Mubeg/Music-Box/README.md

# [Music Box](modules/ROOT/pages/index.adoc)
Данилов Никита Сергеевич  
Черникова Анастасия Алексеевна  

МФТИ ФРКТ, 2023
