Mubeg/Music-Box/modules/ROOT/pages/corpus_phys.adoc

ifdef::env-github[]
:imagesdir: ../images/
endif::[]
ifdef::env-vscode[]
:imagesdir: ../images/
endif::[]
== Производство корпуса

Имея готовый проект осталось только запустить лазерную резку изделия из фанеры.




Можно приступить к xref:corpus_build.adoc[cборке корпуса].
