Mubeg/Music-Box/modules/ROOT/nav.adoc

ifdef::env-github[]
:relfileprefix: pages/
endif::[]
* xref:index.adoc[Музыкальная шкатулка]
** xref:natural_modeling.adoc[1 - Натуральное моделирование]
** xref:shema.adoc[2 - Разработка схемы]
** xref:plata_teor.adoc[3 - Разработка печатной платы]
** xref:plata_phys.adoc[4 - Производство печатной платы]
** xref:corpus_teor.adoc[5 - Разработка корпуса]
** xref:corpus_phys.adoc[6 - Производство корпуса]
** xref:corpus_build.adoc[7 - Сборка копуса]
** xref:plana_build.adoc[8 - Пайка платы]
** xref:complete.adoc[9 - Сборка изделия]
* xref:result.adoc[Результат]
