Mubeg/Music-Box/modules/ROOT/pages/corpus_teor.adoc

ifdef::env-github[]
:imagesdir: ../images/
endif::[]
ifdef::env-vscode[]
:imagesdir: ../images/
endif::[]
== Разработка корпуса

В процессе обсуждения корпуса нашей шкатулки было рассмотрено много различных идей. Но мы решили, что самым эффектным вариантом будет сделать рояль с некоторыми подвижными деталями. В этом случае может быть одновременно хорошо виден корпус, электронная схема и останется место для хранения (изначальная цель любой шкатулки). Для реализации была использована программа CorelDraw, в которой был спроектирован корпус.
Имея результаты прошлых этапов, мы задали необходимый размер, чтобы свободно разместить печатную плату на передней панели.

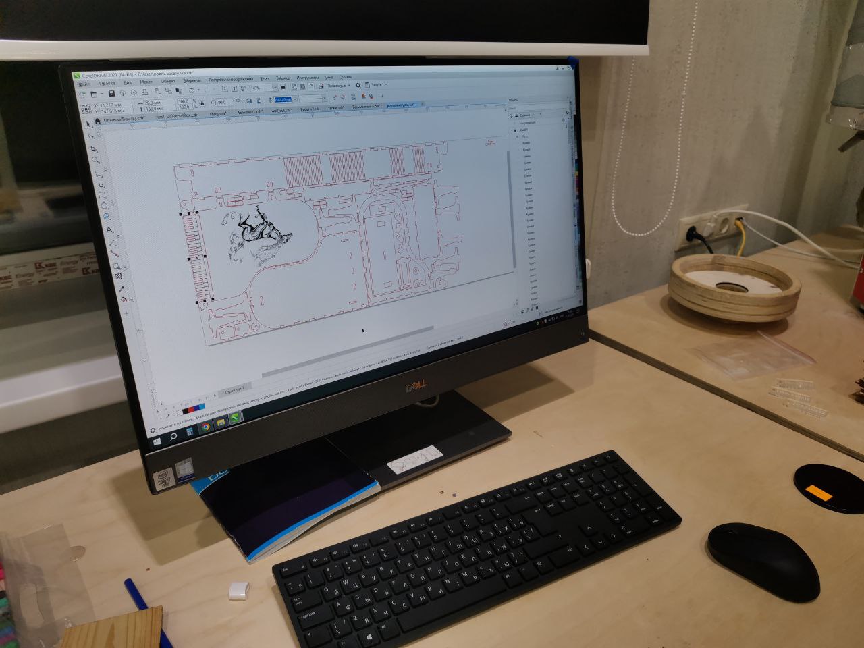
[picture p1: modules/ROOT/images/corpus_2.jpg]


Поскольку в качестве материала для корпуса выступает фанера, для создания изгибов мы прорезали дерево тонкими линиями в специальной последовательности.

Можно приступить к xref:corpus_phys.adoc[производству корпуса].
