Mubeg/Music-Box/modules/ROOT/pages/index.adoc

ifdef::env-github[]
:imagesdir: ../images/
endif::[]
ifdef::env-vscode[]
:imagesdir: ../images/
endif::[]
== Музыкальная шкатулка

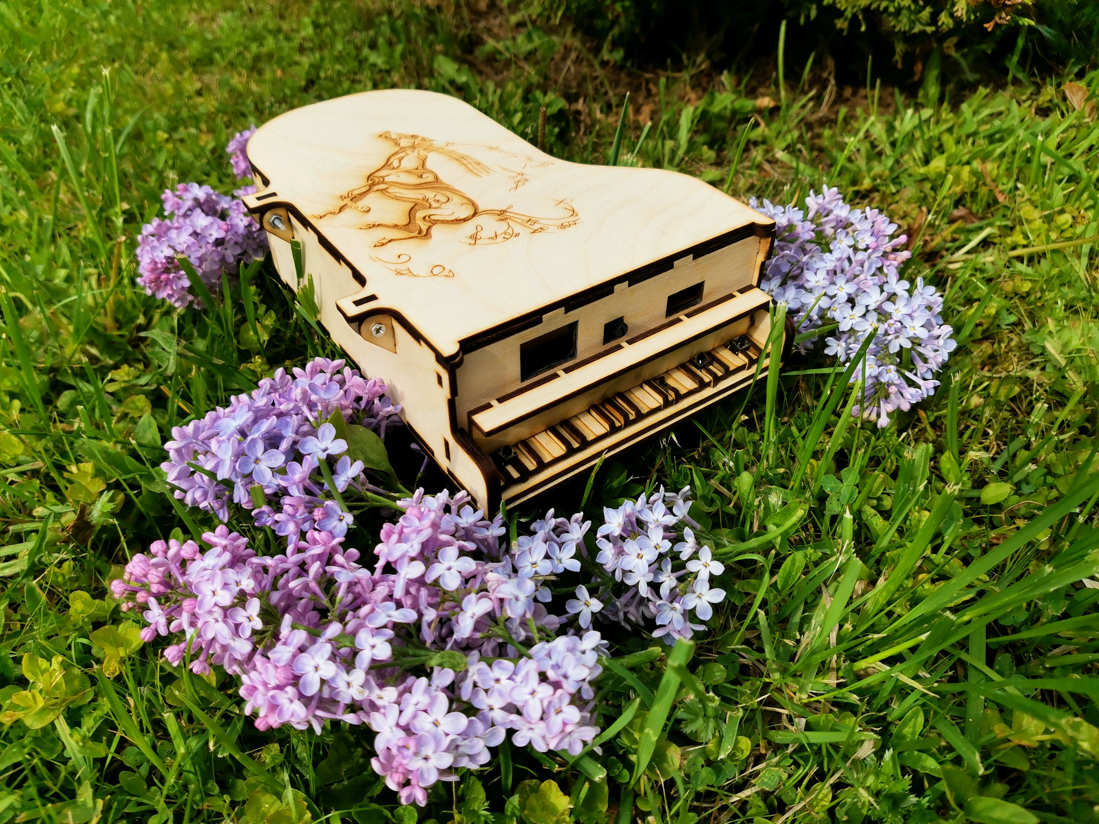
[picture p2: modules/ROOT/images/box_front.jpg]


Все хорошо знакомы со старинными музыкальными шкатулками. Это красивое механическое изделие, которое, к сожалению, способно проигрывать только одну мелодию. Мы захотели создать свою шкатулку, которая сможет воспроизводить любое количество любимых песен и будет радовать своей красотой. С поставленной задачей изделие успешно справляется.

.Пройденные этапы:
. xref:natural_modeling.adoc[Натуральное моделирование]
. xref:shema.adoc[Разработка схемы]
. xref:plata_teor.adoc[Разработка печатной платы]
. xref:plata_phys.adoc[Производство печатной платы]
. xref:corpus_teor.adoc[Разработка корпуса]
. xref:corpus_phys.adoc[Производство корпуса]
. xref:corpus_build.adoc[Сборка корпуса]
. xref:plana_build.adoc[Пайка платы]
. xref:complete.adoc[Сборка изделия]

== xref:result.adoc[Результат]
