Mubeg/Music-Box/modules/ROOT/pages/complete.adoc

ifdef::env-github[]
:imagesdir: ../images/
endif::[]
ifdef::env-vscode[]
:imagesdir: ../images/
endif::[]
== Сборка изделия

Склейка уже готовых элементов произошла без проблем.

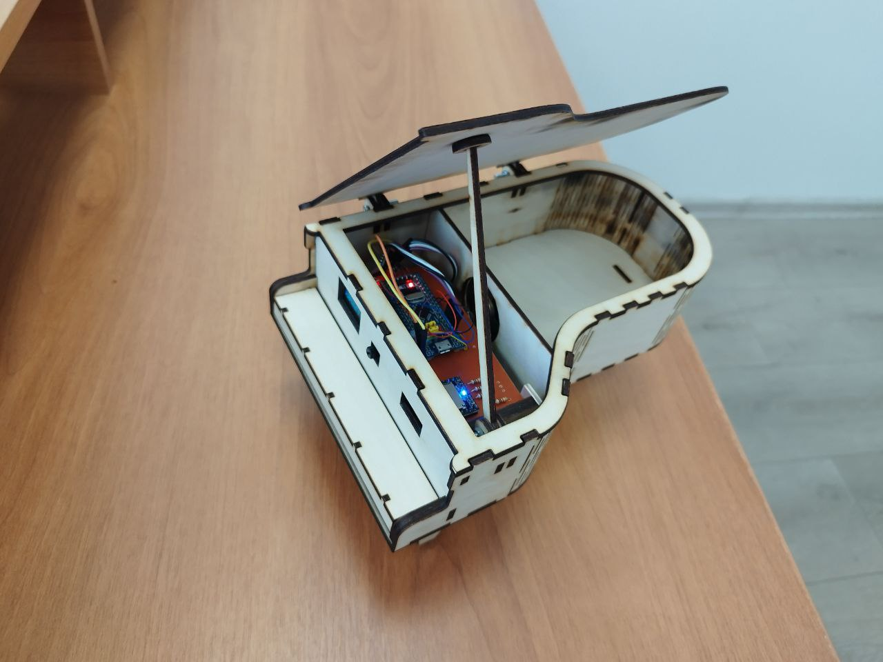
[picture p3: modules/ROOT/images/box_open.jpg]


Дальше необходимо было припаять держатель для батареек. После этого осталось только приклеить последние детали и поставить плату на её место.

После включения питания изделие отказывалось читать SD-карту и играть музыку. Для выяснения причины пришлось проверить напряжения и сопротивления на всей схеме. Узнать её удалось довольно быстро: железный конец резистора отпаялся от окружавшего его олова и потерял контакт. Проблема была быстро решена.

Теперь осталось лишь любоваться xref:result.adoc[результатом].
