Mubeg/Music-Box/modules/ROOT/pages/plata_phys.adoc

ifdef::env-github[]
:imagesdir: ../images/
endif::[]
ifdef::env-vscode[]
:imagesdir: ../images/
endif::[]
== Производство печатной платы

Для производства печатной платы, необходимо станку Charly4U описать задачу. Для этого использовалась программа FlatCAM. После выбора нужных инструментов и количества проходов для добавления окантовки дорожкам, получилась следующая схема.

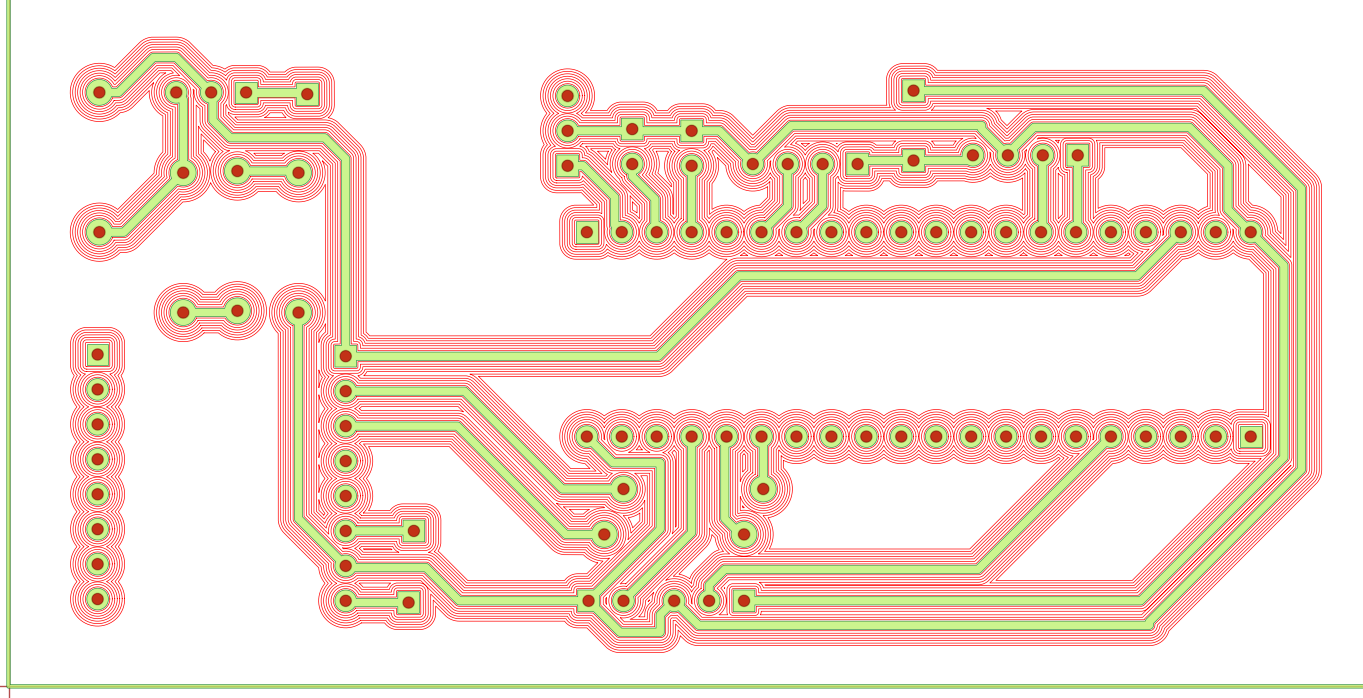
[picture p4: modules/ROOT/images/FlatCam.png]


Этот файл транслируется в формат, который читается станком и, после необходимой настройки, запускается производство.

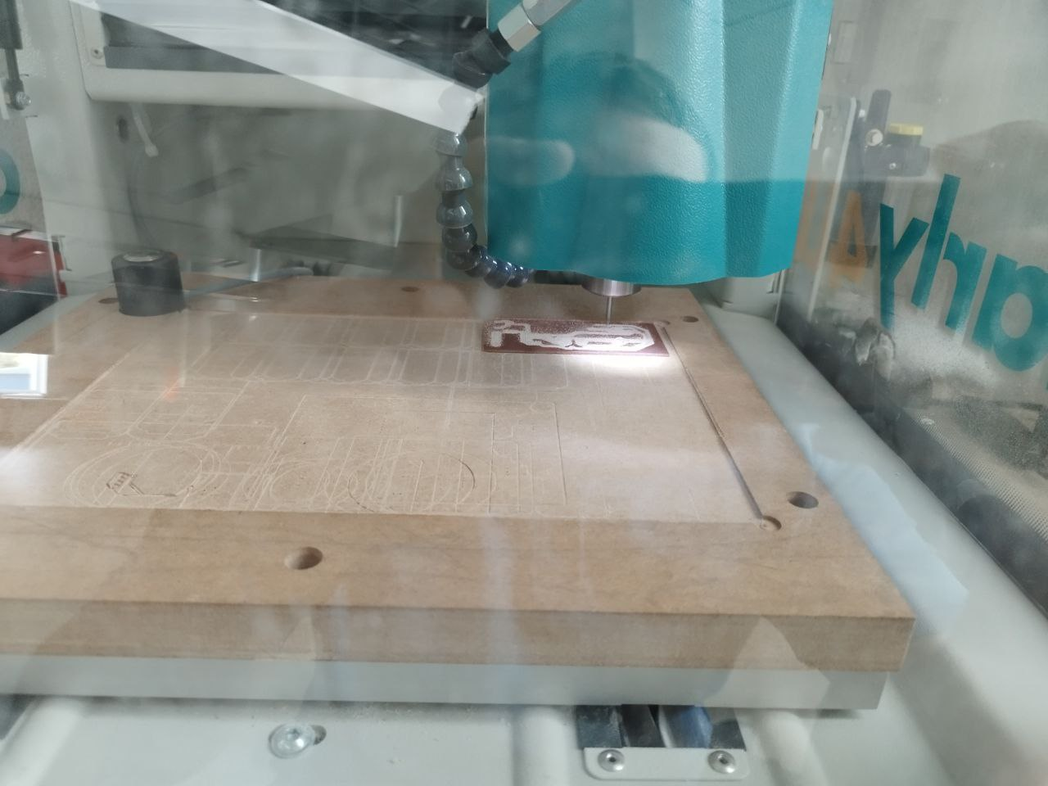
[picture p5: modules/ROOT/images/plata_process.jpg]


Процесс фрезеровки занял 22 минуты, а сверления - 2 минуты. Таким образом суммарное время на изготовку одной платы составляет ~30 минут.

В результате получается медная пластина с вырезанными дорожками и просверленными отверстиями.

Пока готовится плата параллельно можно заниматься xref:corpus_teor.adoc[разработкой корпуса] для изделия.
