Mubeg/Music-Box/modules/ROOT/pages/plata_teor.adoc

ifdef::env-github[]
:imagesdir: ../images/
endif::[]
ifdef::env-vscode[]
:imagesdir: ../images/
endif::[]
== Разработка печатной платы

После создания схемы, её необходимо преобразовать в печатную плату. Мы расположили все элементы на плате и соединили их дорожками - развели плату.

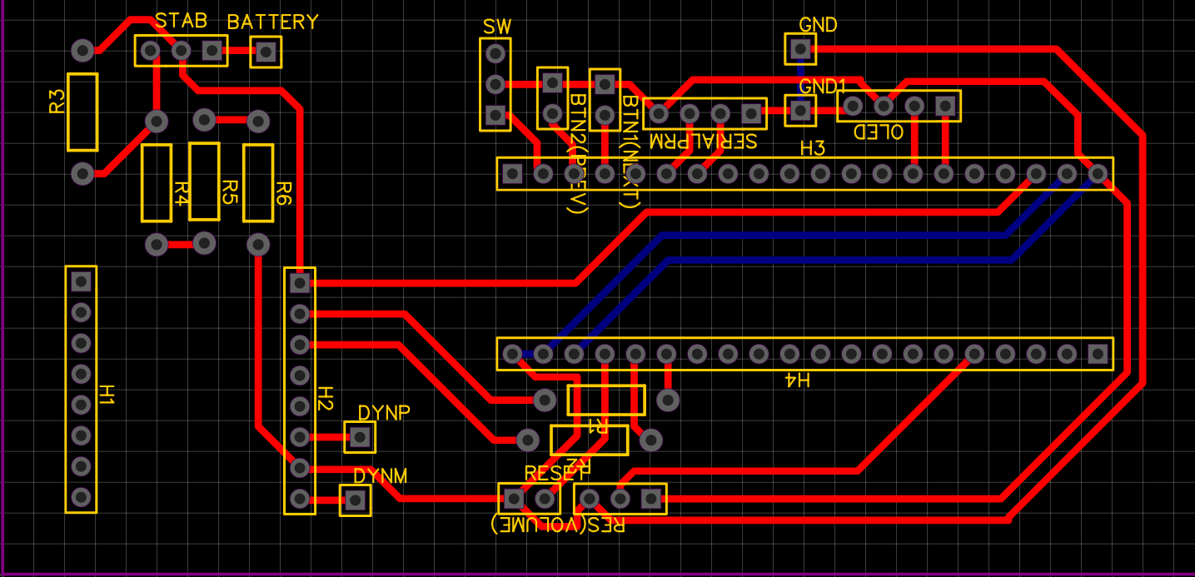
[picture p6: modules/ROOT/images/PCB.png]


Нам были доступны только односторонние медные платы. Это ограничило способы соединения элементов. Из-за этого нам пришлось использовать перемычку, добавленную на этапе пайки. Но место под неё было отведено на текущем этапе.

Процесс работы над печатной платой шёл не так гладко:

* Нам пришлось использовать дорожки на задней плоскости платы, которой не существует (дорожки на изображении отмечены синим), чтобы программа смогла правильно подсказать необходимую разводку. Причина заключается в том, что на плате stm32 3 контакта должны соединяться с землёй, и два с питанием 3,3 В.
* На этом этапе неожиданным образом проявила себя ошибка из предыдущего этапа. Тогда были перепутаны местами земля с питанием. Но, после исправления этой ошибки, логический помощник, продолжал думать, что питание нужно соединить с землей, хотя не давал подключить ни питание к питанию, ни питание к земле. В итоге пришлось вручную изменить номер дорожки питания. На этом этапе мы до конца не понимали, была ли здесь допущена ошибка в соединении каких-либо контактов.
* Последняя сложность заключалась в том, что в процессе разведения платы, о положении компонентов нужно думать зеркально.

После решения всех этих проблем, осталось расположить все компоненты на плату и соединить их. Результат показан на схеме.

В итоге мы упустили только то, что mp3 плеер с разъёмом под sd карту должен был находиться на самом краю платы. Это необходимо, чтобы пользователю было удобно доставать карту для перезаписи музыки.

Настало время приступить к xref:plata_phys.adoc[производству печатной платы].
