Mubeg/Music-Box/modules/ROOT/pages/shema.adoc

ifdef::env-github[]
:imagesdir: ../images/
endif::[]
ifdef::env-vscode[]
:imagesdir: ../images/
endif::[]
== Разработка схемы

Для разработки печатной платы необходимо создать схему электрической цепи нашего изделия. Для этой цели была выбрана программа https://easyeda.com/[EasyEDA], где создали схему.

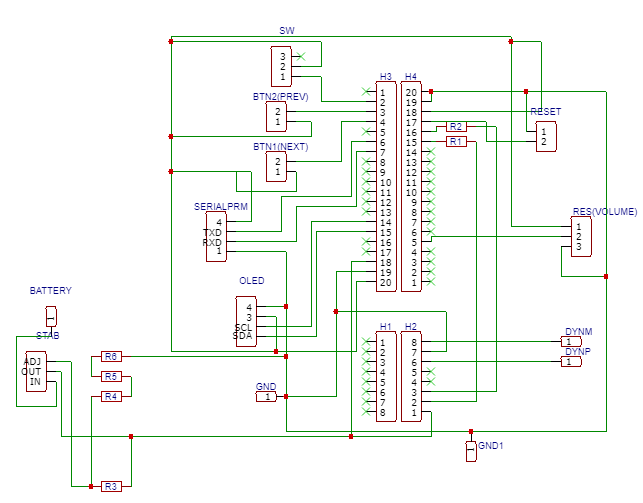
[picture p7: modules/ROOT/images/Shema.png]


Здесь представлены все компоненты с этапа натурального моделирования, но присутствуют некоторые дополнения: добавлен стабилизатор питания, а также кнопка принудительного перезапуска программы микроконтроллера.

В каталоге EasyEDA не было найдено разметки для платы stm32, поэтому нам пришлось её моделировать самостоятельно. В итоге микроконроллер выглядит как два набора по 20 пинов, а mp3-плеер - по 8. Аналогично представлены и другие компоненты.

На рисунке представлена последняя версия схемы, однако, изначально в ней была допущена одна ошибка (mp3 плеер был присоединен питанием к земле). Проблема была быстро исправлена, однако она проявила себя неожиданным образом на этапе xref:plata_teor.adoc[разработки печатной платы].
