Mubeg/Music-Box/modules/ROOT/pages/natural_modeling.adoc

ifdef::env-github[]
:imagesdir: ../images/
endif::[]
ifdef::env-vscode[]
:imagesdir: ../images/
endif::[]
== Натуральное моделирование

Первым этапом в разработке проекта стало натуральное моделирование. На макетной плате была собрана электронная составляющая шкатулки. Были отработаны протоколы взаимодействия микроконтроллера с экраном, mp3-плеером, кнопками, переключателями, потенциометром и динамиком.

.Использованные компоненты:

*   Stm32F103C8T6
*   OLED-экран
*   Mp3-плеер с функцией чтения SD-карты
*   3 кнопки
*   2 переключателя
*   Динамик 0.5 Вт
*   Потенциометр
*   Стабилизатор питания  

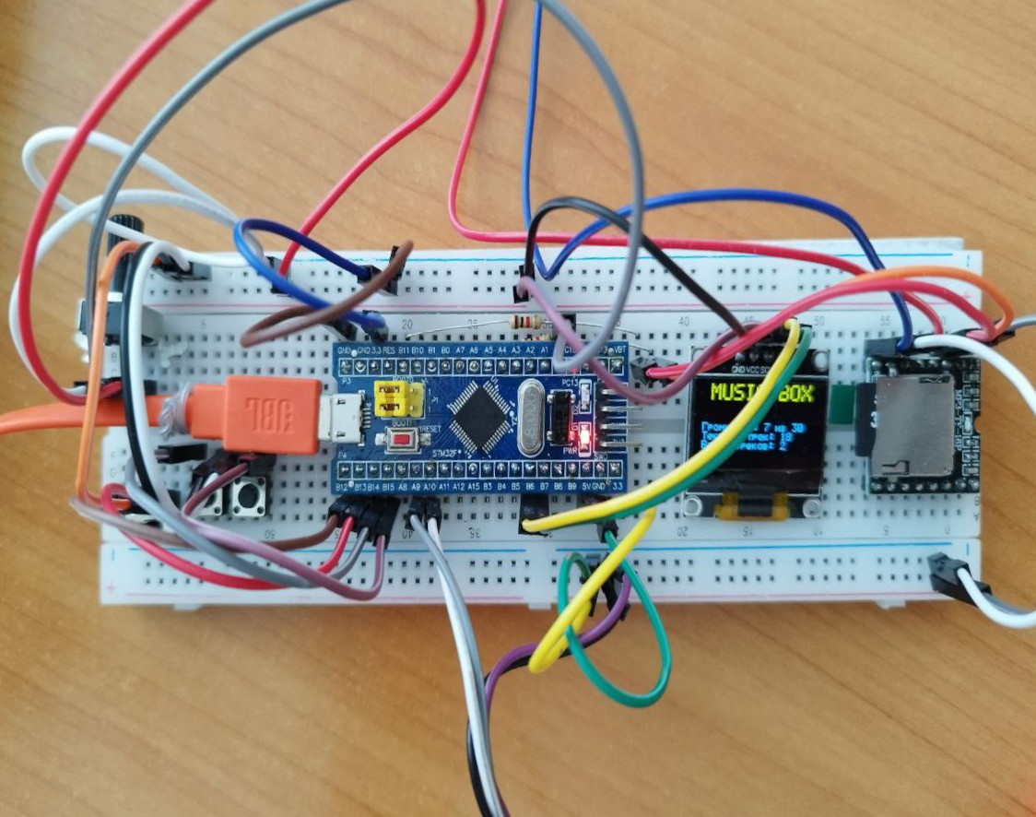
[picture p8: modules/ROOT/images/natural_modeling.jpg]


На этом этапе мы отладили первый вариант кода программы. Но в представленной схеме мы не смогли всё продумать до конца. В дальнейшем будут добавлены питание от батареек (на этой схеме питание подаётся через usb-провод из повербанка), кнопки выключения и перезагрузки.

Некоторые проблемы, оставшиеся от этапа натурального моделирования удалось решить на этапе xref:shema.adoc[разработки схемы].
