Mubeg/Music-Box/(list of files, drawings)

Other design files:
modules/ROOT/sources/EasyEda/1-PCB_PCB_New Project.json
modules/ROOT/sources/EasyEda/1-Schematic_New Project.json
