Mubeg/Music-Box/modules/ROOT/sources/Gerber_PCB_PCB_Electronics_2_1_2023-05-12/How-to-order-PCB.txt

How to Order PCB

Please refer to:
https://docs.easyeda.com/en/PCB/Order-PCB
