Mubeg/Music-Box/modules/ROOT/pages/corpus_build.adoc

ifdef::env-github[]
:imagesdir: ../images/
endif::[]
ifdef::env-vscode[]
:imagesdir: ../images/
endif::[]
== Сборка корпуса

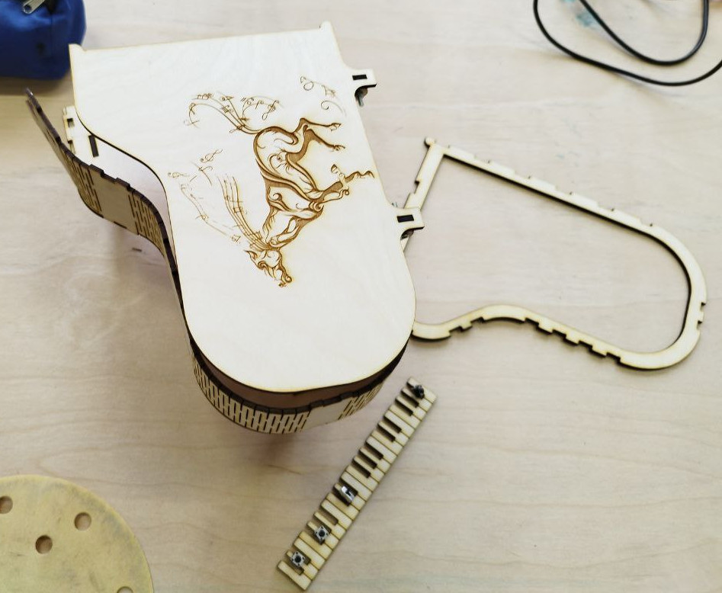
[picture p9: modules/ROOT/images/box_assembly.jpg]


На этапе сборки корпуса было придумано решение разместить кнопки управления как клавиши рояля, что потребовало некоторых изменений в конструкции. Так, панель с белыми клавишами и передней стенкой была размещена выше запланированного места, чтобы можно было проложить провода до кнопок.

Также на этом этапе была произведена новая передняя панель с вырезанными отверстиями под SD-карту, потенциометр и экран.

Помимо прочего, была изготовлена конструкция удержания печатной платы на необходимой высоте, под неё мы поместили корпус с батарейками.

Вся конструкция будет склеиваться воедино уже на следующем этапе, когда будет xref:plana_build.adoc[спаяна печатная плата].
