Mubeg/Music-Box/modules/ROOT/pages/plana_build.adoc

ifdef::env-github[]
:imagesdir: ../images/
endif::[]
ifdef::env-vscode[]
:imagesdir: ../images/
endif::[]
==  Пайка платы

Для завершения этапа разработки электроники, осталось припаять все компоненты на плату и проверить её работоспособность.

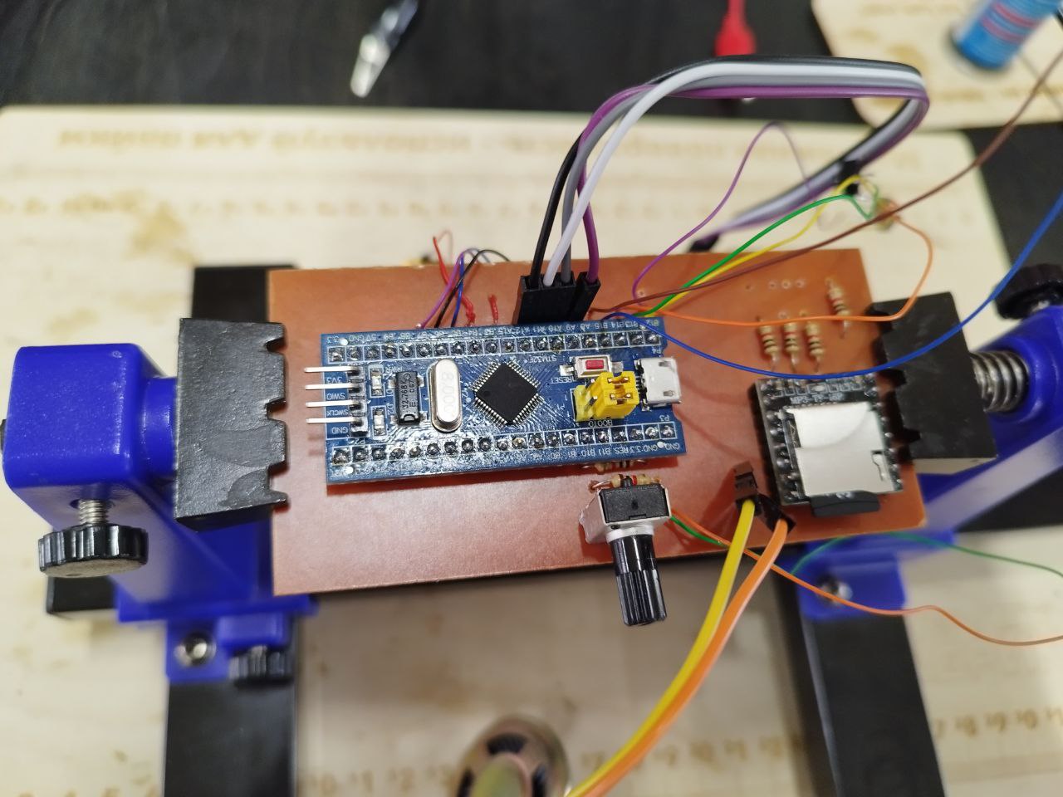
[picture p10: modules/ROOT/images/plata_front.jpg]

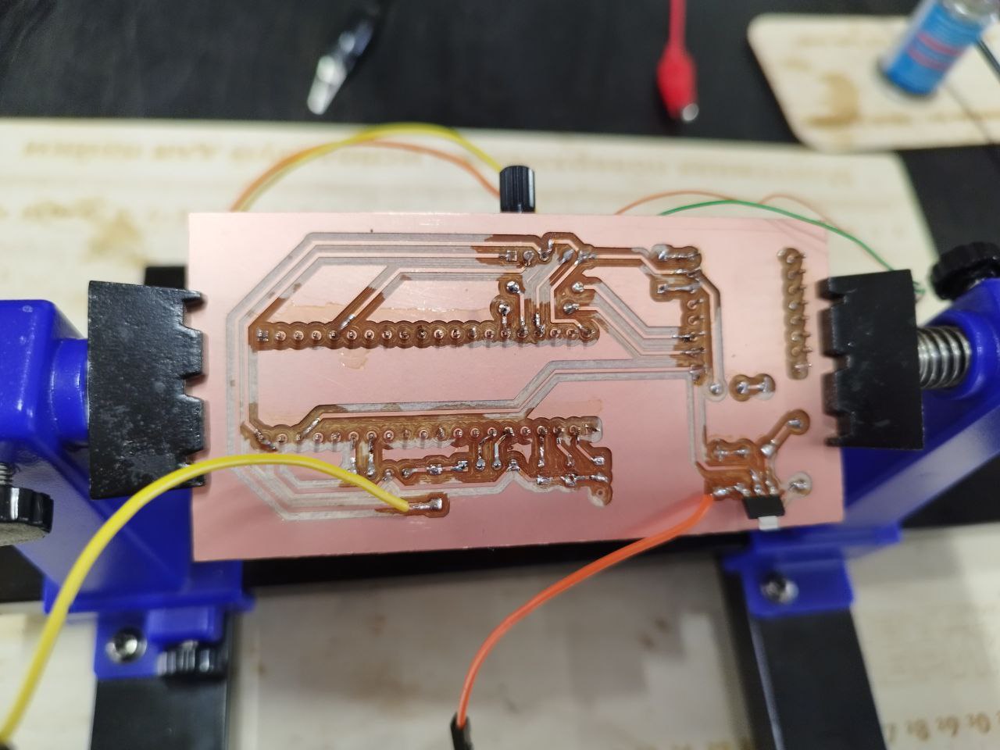
[picture p11: modules/ROOT/images/palata_back.jpg]


.Процесс пайки прошел гладко, за исключением фактора:

* В месте крепления питания стабилизатора, отклеился медный слой, что исключило использование данного контакта. Для обхода возникшей проблемы, провод питания был присоединен напрямую к стабилизатору.

В итоге - подключаем плату к источнику питания - и она работает! :D

На одну неизвестность меньше, приступаем к xref:complete.adoc[сборке изделия].
