Mubeg/Music-Box/modules/ROOT/pages/result.adoc

ifdef::env-github[]
:imagesdir: ../images/
endif::[]
ifdef::env-vscode[]
:imagesdir: ../images/
endif::[]
== Результат

Получилось красивое и функциональное изделие.

.Преимущества:
* Качественное и громкое звучание
* До 300 часов работы в режиме ожидания
* До 30 часов работы в режиме умеренной громкости
* Безграничное количество треков *
* Объемное место для хранения предметов

(*) До 32 ГБ на SD-карте



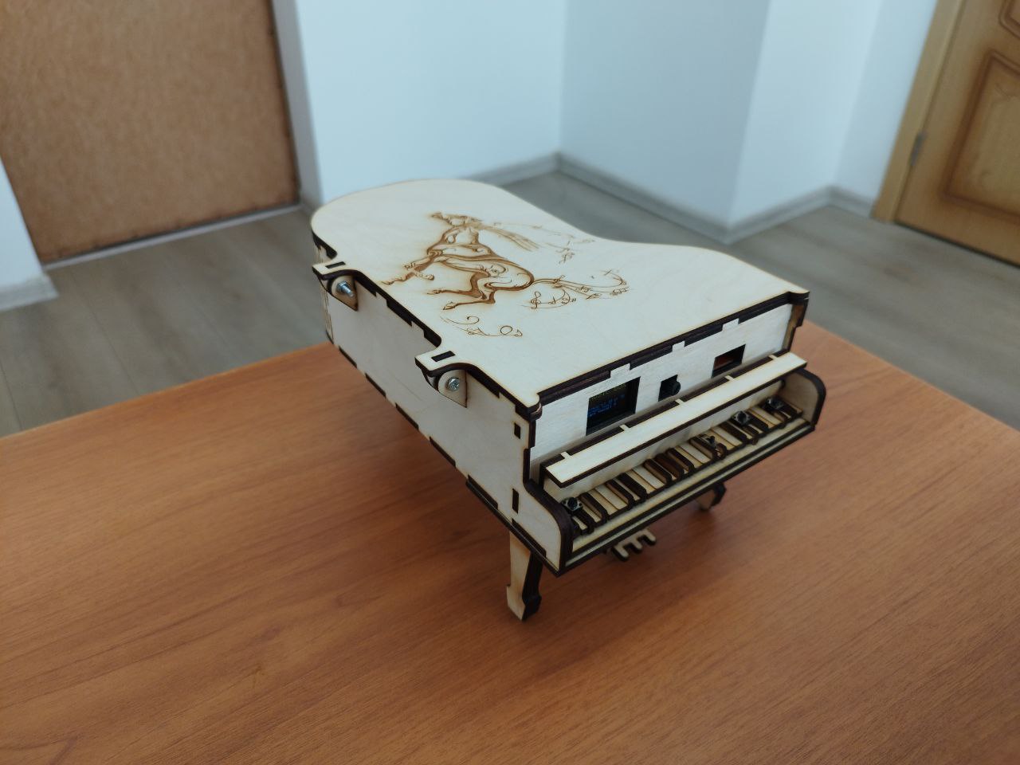
[picture p12: modules/ROOT/images/Royal'.jpg]




ifdef::env-github[]

endif::[]

Перейти в xref:index.adoc[начало].
